forgeVII/TBAS/media/README.md

# Media — TBAS

## Videos

| File | Description |
|---|---|
| `Acoustic test.mp4` | Acoustic direction finding test — servo tracking sound |
| `Final working and explaination of tbas in hinglish.mp4` | Complete TBAS explanation in Hinglish |

## Photos

| File | Description |
|---|---|
| `Raw look after mounting all components.jpg` | All components mounted on zero board |
| `Electronics on zero board.jpg` | Arduino Nano and wiring closeup |
| `Circuit diagram.jpg` | Full circuit schematic |
