forgeVII/TBAS/docs/youtube_videos.md

# YouTube Video Details — Upload as Unlisted

---

## Video 1: Acoustic Test

**Title:** TBAS — Acoustic Direction Finding Test (Arduino TDOA System)

**Description:**
```
Testing the acoustic detection system of TBAS (Tactical Battlefield Awareness Suite).

Two electret microphones spaced 28cm apart detect sound. TDOA (Time Difference of Arrival) physics calculates the angle. A servo rotates toward the source in real time.

What you'll see:
- Sound detection from different angles
- Servo tracking the sound source
- TDOA calculation accuracy
- Response time and detection range

Hardware: Arduino Nano, 2× electret microphones, LM393 comparator, servo motor

Full documentation: https://github.com/forgeVII-org/TBAS

#Arduino #AcousticDetection #TDOA #DirectionFinding #EmbeddedSystems
```

---

## Video 2: Full Explanation in Hinglish

**Title:** TBAS — Complete Explanation in Hinglish (Tactical Battlefield Awareness Suite)

**Description:**
```
TBAS (Tactical Battlefield Awareness Suite) ka complete explanation Hinglish mein.

Is video mein bataya hai:
- TBAS kya hai aur kaise kaam karta hai
- Acoustic direction finding kaise hota hai (TDOA)
- IFF (Identification Friend or Foe) system kaise work karta hai
- Rolling code security kaise hoti hai
- Web interface kaise connect hota hai
- Har mode kya karta hai (Manual, Surveillance, Servo Test, Acoustic)
- Pin mapping aur wiring
- Sab kuch detail mein

Hardware: Arduino Nano, 2× electret microphones, LM393 comparator, servo motor, TSOP1838 IR receiver, RGB LED

Full documentation: https://github.com/forgeVII-org/TBAS

#Arduino #TBAS #Hinglish #EmbeddedSystems #IFF #AcousticDetection
```

---

## Upload Settings (Same for Both)

- **Visibility:** Unlisted
- **Category:** Science & Technology
- **Comments:** On
- **License:** Creative Commons — Attribution
- **Playlist:** Create "TBAS — Tactical Battlefield Awareness Suite" playlist and add both
