forgeVII/TBAS/(commit log)

2026-07-22 Restructure repo: add README, firmware, wiring docs, YouTube placeholders
2026-07-22 Update media references — videos before photos, matching actual files
2026-07-23 Add YouTube links and circuit diagram photo
